twd2/THCOMIPS16e/pre.pptx

## THCO MIPS指令计算机系统设计和实现

Project 4 & 5

## 我们做了什么?

- 指令集实现
- VGA显示
- PS/2键盘
- SD卡访问
  - bootloader
  - 读
  - 写
  - DMA
- 2048游戏
- Bad Apple动画

## datapath

## VGA显示
