twd2/THCOMIPS16e/doc/datapath.png

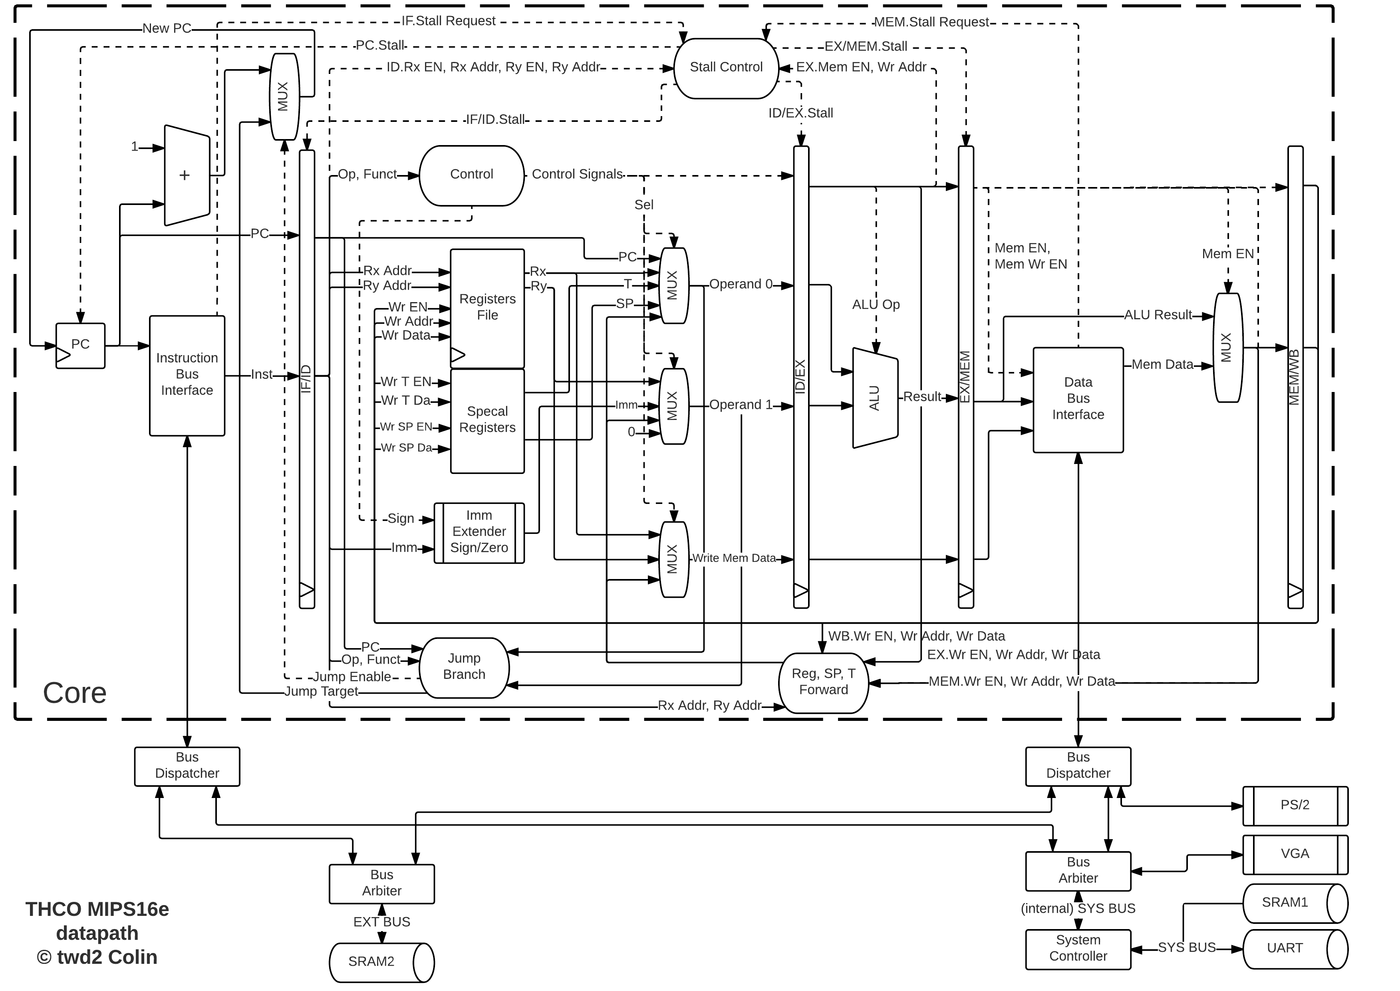
doc/datapath.png
