twd2/THCOMIPS16e/doc/datapath.pdf

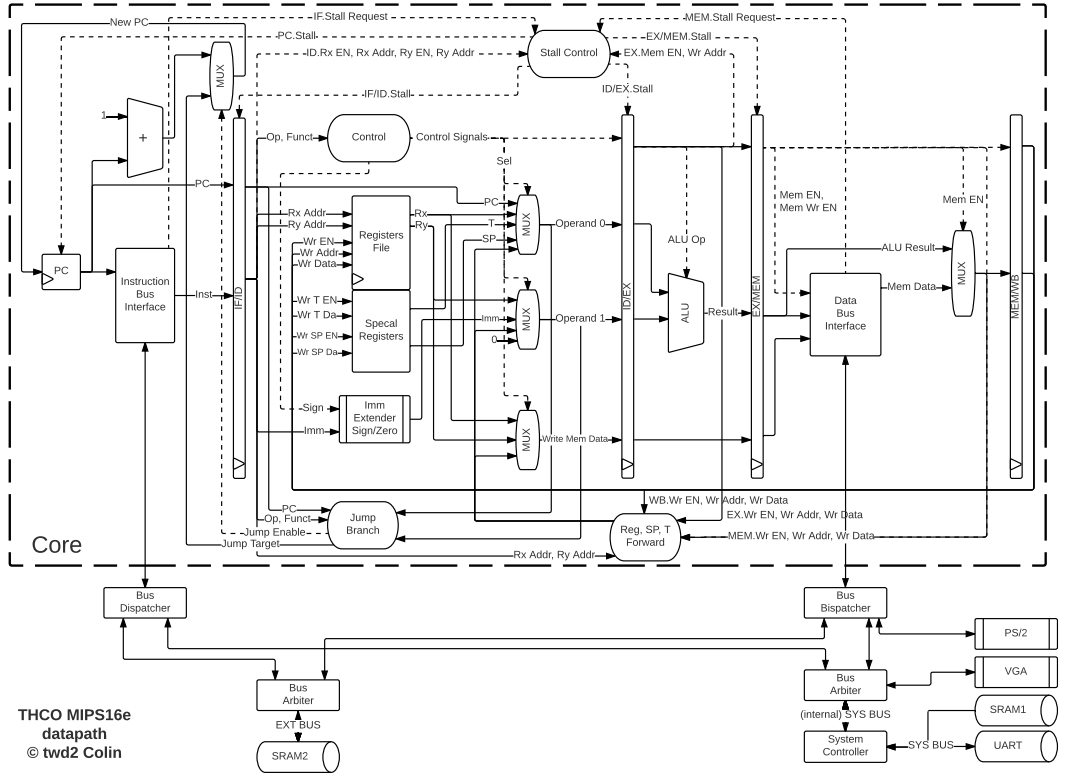
[picture p13: page 1]
Stall Control; MEM/WB; EX/MEM; Instruction Bus; Interface; Data; Bus Interface; Registers File; Bus Dispatcher; Bus Bispatcher; Specal Registers; Bus Arbiter; System Controller SRAM2; SRAM1; UART; Control; Imm Extender Sign/Zero; Jump; Branch; Reg, SP, T; Forward; EXT BUS; SYS BUS; New PC; Inst; Imm; Operand 0; Operand 1; ALU; Mem Data; Result; ALU Result; Jump Enable Jump Target; Control Signals; Wr Addr; Op, Funct; Wr Data; Sel; Sign; IF.Stall Request; MEM.Stall Request; VGA; ALU Op; Core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

PC.Stall
ID.Rx EN, Rx Addr, Ry EN, Ry Addr

EX/MEM.Stall
EX.Mem EN, Wr Addr

IF/ID.Stall

ID/EX.Stall

Mem EN Mem EN, Mem Wr EN

Rx Addr Ry Addr

Write Mem Data

WB.Wr EN, Wr Addr, Wr Data

EX.Wr EN, Wr Addr, Wr Data
MEM.Wr EN, Wr Addr, Wr Data

Rx Addr, Ry Addr

(internal) SYS BUS
