twd2/THCOMIPS16e/sopc/sd_controller.vhd

-- MIT License
-- 
-- Copyright (c) 2017 Wende Tan, Liu Minghua
-- 
-- Permission is hereby granted, free of charge, to any person obtaining a copy
-- of this software and associated documentation files (the "Software"), to deal
-- in the Software without restriction, including without limitation the rights
-- to use, copy, modify, merge, publish, distribute, sublicense, and/or sell
-- copies of the Software, and to permit persons to whom the Software is
-- furnished to do so, subject to the following conditions:
-- 
-- The above copyright notice and this permission notice shall be included in all
-- copies or substantial portions of the Software.
-- 
-- THE SOFTWARE IS PROVIDED "AS IS", WITHOUT WARRANTY OF ANY KIND, EXPRESS OR
-- IMPLIED, INCLUDING BUT NOT LIMITED TO THE WARRANTIES OF MERCHANTABILITY,
-- FITNESS FOR A PARTICULAR PURPOSE AND NONINFRINGEMENT. IN NO EVENT SHALL THE
-- AUTHORS OR COPYRIGHT HOLDERS BE LIABLE FOR ANY CLAIM, DAMAGES OR OTHER
-- LIABILITY, WHETHER IN AN ACTION OF CONTRACT, TORT OR OTHERWISE, ARISING FROM,
-- OUT OF OR IN CONNECTION WITH THE SOFTWARE OR THE USE OR OTHER DEALINGS IN THE
-- SOFTWARE.

library IEEE;
use IEEE.std_logic_1164.all;
use IEEE.std_logic_unsigned.all;
use IEEE.std_logic_arith.all;
use work.constants.all;
use work.types.all;

entity sd_controller is
    generic
    (
        WORD_WIDTH: integer := word_length; -- word width of SRAM
        RAM_SIZE: integer := 32 * 1024 * 16 / 8 -- SRAM size (bytes)
    );
    port
    (
        CLK: in std_logic;
        RST: in std_logic;

        DMA_BUS_REQ: out bus_request_t;
        DMA_BUS_RES: in bus_response_t;
        
        BUS_REQ: in bus_request_t;
        BUS_RES: out bus_response_t;

        SD_nCS: out std_logic; -- SD_NCS, SD_DATA3_CD
        SD_SCLK: out std_logic; -- SD_CLK
        SD_MISO: in std_logic;  -- SD_DOUT, SD_DATA0_DO
        SD_MOSI: out std_logic; -- SD_DIN, SD_CMD

        DONE: out std_logic;
        REJECTED: out std_logic;
        DBG: out std_logic_vector(3 downto 0);
        
        IRQ: out std_logic
    );
end;

architecture behavioral of sd_controller is
    -- timing constants
    constant POWERON_WAIT_CYCLES: integer := 25000; -- 1ms, if CLK = 25M
    constant SPI_WAIT_CYCLES: integer := 1;
    constant DUMMY_CLOCKS: integer := 80;
    constant MAX_RETRY: integer := 16;

    -- data length
    constant CMD_BITS: integer := 48;
    constant BYTE_BITS: integer := 8;
    constant R1_BITS: integer := 8;
    constant DWORD_BUFF_BITS: integer := 32;
    constant SECTOR_SIZE: integer := 512;
    constant WORD_SIZE: integer := WORD_WIDTH / 8;

    -- expected responses
    constant R1_NO_ERROR_IDLE: std_logic_vector(7 downto 0) := x"01";
    constant R1_ILLIGAL_CMD_IDLE: std_logic_vector(7 downto 0) := x"05";
    constant R1_NO_ERROR_NO_IDLE: std_logic_vector(7 downto 0) := x"00";
    constant CMD25_DATA_TOKEN: std_logic_vector(7 downto 0) := x"FC";
    constant CMD25_STOP_TOKEN: std_logic_vector(7 downto 0) := x"FD";

    -- :-)
    type state_t is (st_poweron_wait, st_dummy_clock,
                     st_cmd0_req, st_cmd0_res, st_cmd0_done,
                     st_cmd8_req, st_cmd8_res, st_cmd8_read_r1, st_cmd8_done,
                     st_acmd41_cmd55_req, st_acmd41_cmd55_res, st_acmd41_cmd55_done,
                     st_acmd41_req, st_acmd41_res, st_acmd41_done,
                     st_cmd58_req, st_cmd58_res, st_cmd58_read_r1, st_cmd58_done,
                     st_cmd16_req, st_cmd16_res, st_cmd16_done,
                     st_cmd17_req, st_cmd17_res, st_cmd17_r1,
                     st_cmd17_read_token, st_cmd17_read_data, st_cmd17_read_crc,
                     st_cmd17_write_ram, st_cmd17_write_ram_done, st_cmd17_done,
                     st_cmd25_req, st_cmd25_res, st_cmd25_r1,
                     st_cmd25_send_token, st_cmd25_read_ram, st_cmd25_read_ram_done,
                     st_cmd25_send_data, st_cmd25_send_crc,
                     st_cmd25_read_data_res, st_cmd25_read_data_res2,
                     st_cmd25_next, st_cmd25_send_stop, st_cmd25_done,
                     st_wait_spi, st_send_cmd, st_send_byte, st_wait_busy,
                     st_read_wait, st_read_byte, st_read_4_bytes,
                     st_finish_delay,
                     st_reject, st_done, st_ready);

    signal current_state, wait_return_state, wait_busy_return_state, cmd_return_state, ram_return_state: state_t;

    -- wait_counter ranged 0 to max(SPI_WAIT_CYCLES, POWERON_WAIT_CYCLES) - 1
    signal wait_counter: integer range 0 to POWERON_WAIT_CYCLES - 1;
    signal counter: integer range 0 to 255; -- >= max(DUMMY_CLOCKS, CMD_BITS) * 2 - 1
    signal byte_counter: integer range 0 to SECTOR_SIZE - 1;
    signal retry_counter: integer range 0 to MAX_RETRY - 1; -- TODO: retry
    signal sector_counter: integer range 0 to integer'high;

    signal sd_sclk_buff: std_logic;

    -- (request) command and argument
    signal cmd: integer range 0 to 63;
    signal arg: std_logic_vector(31 downto 0);
    signal crc: std_logic_vector(6 downto 0);
    signal packet: std_logic_vector(47 downto 0);
    signal sector_as_arg: std_logic_vector(31 downto 0);
    signal finish_delay: std_logic; -- delay or not after a command

    -- buffers
    signal byte_buff: std_logic_vector(7 downto 0);
    signal dword_buff: std_logic_vector(31 downto 0);
    signal word_buff: std_logic_vector(WORD_WIDTH - 1 downto 0);

    -- SD card properties
    signal is_sdc2, is_sdhc: std_logic;
    
    signal booted: std_logic;
    
    signal last_state: state_t;
    
    -- registers
    signal irq_buff: std_logic;
    signal sector_base: std_logic_vector(31 downto 0);
    signal ram_base: std_logic_vector(31 downto 0);
    signal sector_count: std_logic_vector(31 downto 0);
begin
    SD_SCLK <= sd_sclk_buff;

    packet <= "01" & conv_std_logic_vector(cmd, 6) & arg & crc & "1";

    sector_as_arg_process:
    process(sector_counter, is_sdhc)
    begin
        -- block addressing when SD card is SDHC/SDXC, otherwise, byte addressing.
        -- ref:
        -- SD Specifications Part 1 Physical Layer Simplified Specification
        --     Table 7-3 : Commands and Arguments (small print)
        --     10. SDSC Card (CCS=0) uses byte unit address and 
        --     SDHC and SDXC Cards (CCS=1) use block unit address (512 bytes unit).
        if is_sdhc = '1' then -- block addressing
            sector_as_arg <= conv_std_logic_vector(conv_integer(unsigned(sector_base)) + sector_counter, sector_as_arg'length);
        else -- byte addressing, 512 bytes aligned
            sector_as_arg <= conv_std_logic_vector((conv_integer(unsigned(sector_base)) + sector_counter) * SECTOR_SIZE,
                                                   sector_as_arg'length);
        end if;
    end process;
    
    DMA_BUS_REQ.is_uart_data <= '0';
    DMA_BUS_REQ.is_uart_control <= '0';
    
    process(CLK, RST)
    begin
        if RST = '1' then
            current_state <= st_poweron_wait;
            wait_counter <= 0;
            counter <= 0;
            sd_sclk_buff <= '0';
            SD_nCS <= '1';
            SD_MOSI <= '1';
            byte_buff <= (others => '0');
            dword_buff <= (others => '0');
            DBG <= (others => '0');
            retry_counter <= 0;
            is_sdc2 <= '0';
            is_sdhc <= '0';
            finish_delay <= '1';
            sector_counter <= 0;
            byte_counter <= 0;
            DMA_BUS_REQ.en <= '1';
            DMA_BUS_REQ.nread_write <= '0';
            DMA_BUS_REQ.byte_mask <= (others => '1');
            DMA_BUS_REQ.addr <= (others => '0');
            booted <= '0';
        elsif rising_edge(CLK) then
            case current_state is
                ------------------------------------------------------------------------------
                -- SD card initialization
                -- ref:
                -- SD Specifications Part 1 Physical Layer Simplified Specification
                --     7.2.1 Mode Selection and Initialization
                --     Figure 7-2 : SPI Mode Initialization Flow
                -- 1. wait 1+ ms
                when st_poweron_wait =>
                    sd_sclk_buff <= '1';
                    if wait_counter = POWERON_WAIT_CYCLES - 1 then
                        current_state <= st_dummy_clock;
                        wait_counter <= 0;
                    else
                        wait_counter <= wait_counter + 1;
                    end if;
                -- 2. 74+ dummy clocks
                when st_dummy_clock =>
                    SD_nCS <= '1';
                    SD_MOSI <= '1';
                    sd_sclk_buff <= not sd_sclk_buff;
                    if counter = DUMMY_CLOCKS * 2 - 1 then
                        wait_return_state <= st_cmd0_req;
                        current_state <= st_wait_spi;
                        counter <= 0;
                    else
                        wait_return_state <= st_dummy_clock;
                        current_state <= st_wait_spi;
                        counter <= counter + 1;
                    end if;
                -- 3. CMD0 GO_IDLE_STATE
                when st_cmd0_req =>
                    SD_nCS <= '0';
                    cmd <= 0;
                    arg <= x"00000000";
                    crc <= "1001010"; -- CRC is needed.
                    cmd_return_state <= st_cmd0_res;
                    current_state <= st_send_cmd;
                    counter <= 0;
                when st_cmd0_res =>
                    finish_delay <= '0';
                    cmd_return_state <= st_cmd0_done;
                    current_state <= st_read_wait;
                when st_cmd0_done =>
                    if byte_buff = R1_NO_ERROR_IDLE then
                        current_state <= st_cmd8_req;
                    else
                        DBG <= x"1";
                        current_state <= st_reject;
                    end if;
                -- 4. CMD8 SEND_IF_COND
                when st_cmd8_req =>
                    SD_nCS <= '0';
                    cmd <= 8;
                    arg <= x"000001AA";
                    crc <= "1000011"; -- CRC is needed.
                    cmd_return_state <= st_cmd8_res;
                    current_state <= st_send_cmd;
                    counter <= 0;
                when st_cmd8_res =>
                    finish_delay <= '0';
                    cmd_return_state <= st_cmd8_read_r1;
                    current_state <= st_read_wait;
                when st_cmd8_read_r1 =>
                    if byte_buff = R1_NO_ERROR_IDLE then
                        -- This card supports CMD8, so it is SDC2+.
                        is_sdc2 <= '1';
                        finish_delay <= '1';
                        cmd_return_state <= st_cmd8_done;
                        current_state <= st_read_4_bytes;
                    elsif byte_buff = R1_ILLIGAL_CMD_IDLE then
                        -- Otherwise, it is SDC1.
                        is_sdc2 <= '0';
                        cmd_return_state <= st_acmd41_cmd55_req;
                        current_state <= st_finish_delay;
                    else
                        -- TODO: retry count
                        DBG <= x"8";
                        current_state <= st_cmd8_req;
                    end if;
                when st_cmd8_done =>
                    if dword_buff(11 downto 0) = x"1AA" then
                        -- magic number matches
                        current_state <= st_acmd41_cmd55_req;
                    else
                        DBG <= x"8";
                        current_state <= st_reject;
                    end if;
                -- 5.1 CMD55 APP_CMD for ACMD41
                when st_acmd41_cmd55_req =>
                    SD_nCS <= '0';
                    cmd <= 55; -- well, it's decimal.
                    arg <= x"00000000";
                    crc <= "0110010"; -- actually, don't care
                    cmd_return_state <= st_acmd41_cmd55_res;
                    current_state <= st_send_cmd;
                    counter <= 0;
                when st_acmd41_cmd55_res =>
                    finish_delay <= '1';
                    cmd_return_state <= st_acmd41_cmd55_done;
                    current_state <= st_read_wait;
                when st_acmd41_cmd55_done =>
                    if byte_buff = R1_NO_ERROR_IDLE then
                        -- SD_nCS <= '1';
                        current_state <= st_acmd41_req;
                    else
                        -- TODO: retry count
                        current_state <= st_acmd41_cmd55_req; -- ???
                        DBG <= x"5";
                        -- current_state <= st_reject;
                    end if;
                -- 5.2 ACMD41 APP_SEND_OP_COND
                when st_acmd41_req =>
                    SD_nCS <= '0';
                    cmd <= 41;
                    if is_sdc2 = '1' then
                        -- HCS = 1, declares this controller supports high capacity cards.
                        arg <= x"40000000";
                        crc <= "0111011"; -- actually, don't care
                    else
                        arg <= x"00000000"; -- HCS = 0
                        crc <= "1110010"; -- actually, don't care
                    end if;
                    cmd_return_state <= st_acmd41_res;
                    current_state <= st_send_cmd;
                    counter <= 0;
                when st_acmd41_res =>
                    finish_delay <= '1';
                    cmd_return_state <= st_acmd41_done;
                    current_state <= st_read_wait;
                when st_acmd41_done =>
                    if byte_buff = R1_NO_ERROR_IDLE then
                        -- loop until the card responses R1_NO_ERROR_NO_IDLE
                        --                                           ~~~~~~~
                        current_state <= st_acmd41_cmd55_req;
                    elsif byte_buff = R1_NO_ERROR_NO_IDLE then
                        -- the card is initialized.
                        current_state <= st_cmd58_req;
                    else
                        -- current_state <= st_cmd55_req; -- ???
                        DBG <= x"4";
                        current_state <= st_reject;
                    end if;
                -- 6. CMD58 READ_OCR
                when st_cmd58_req =>
                    SD_nCS <= '0';
                    cmd <= 58;
                    arg <= x"00000000";
                    crc <= "1111110"; -- actually, don't care
                    cmd_return_state <= st_cmd58_res;
                    current_state <= st_send_cmd;
                    counter <= 0;
                when st_cmd58_res =>
                    finish_delay <= '0';
                    cmd_return_state <= st_cmd58_read_r1;
                    current_state <= st_read_wait;
                when st_cmd58_read_r1 =>
                    if byte_buff = R1_NO_ERROR_NO_IDLE then
                        finish_delay <= '1';
                        cmd_return_state <= st_cmd58_done;
                        current_state <= st_read_4_bytes;
                    else
                        -- TODO: retry count
                        DBG <= x"8";
                        current_state <= st_reject;
                    end if;
                when st_cmd58_done =>
                    -- read CCS bit.
                    -- ref: SD Specifications Part 1 Physical Layer Simplified Specification
                    --     Table 5-1 : OCR Register Definition
                    --     30 Card Capacity Status (CCS)1
                    --     1) This bit is valid only when the card power up status bit is set.
                    is_sdhc <= dword_buff(30); -- CCS, '1' represents high capacity card
                    current_state <= st_cmd16_req;
                -- 7. CMD16 SET_BLOCKLEN
                -- This command ensures block length 512 bytes for SDSC. 
                -- In case of SDHC and SDXC Cards,
                -- block length of the memory access commands are fixed to 512 bytes.
                when st_cmd16_req =>
                    SD_nCS <= '0';
                    cmd <= 16;
                    arg <= x"00000200"; -- 512 bytes per block
                    crc <= "0001010"; -- actually, don't care
                    cmd_return_state <= st_cmd16_res;
                    current_state <= st_send_cmd;
                    counter <= 0;
                when st_cmd16_res =>
                    finish_delay <= '1';
                    cmd_return_state <= st_cmd16_done;
                    current_state <= st_read_wait;
                when st_cmd16_done =>
                    if byte_buff = R1_NO_ERROR_NO_IDLE then
                        -- SD card is initialized.
                        current_state <= st_cmd17_req; -- bootloader
                        -- use st_ready to skip bootloader
                    else
                        DBG <= x"6";
                        current_state <= st_reject;
                    end if;
                ------------------------------------------------------------------------------
                -- Reader: CMD17 READ_SINGLE_BLOCK
                when st_cmd17_req =>
                    SD_nCS <= '0';
                    cmd <= 17;
                    arg <= sector_as_arg;
                    crc <= "1111111"; -- actually, don't care
                    cmd_return_state <= st_cmd17_res;
                    current_state <= st_send_cmd;
                    counter <= 0;
                when st_cmd17_res =>
                    finish_delay <= '0';
                    cmd_return_state <= st_cmd17_r1;
                    current_state <= st_read_wait;
                when st_cmd17_r1 =>
                    DBG <= x"C";
                    if byte_buff = R1_NO_ERROR_NO_IDLE then
                        cmd_return_state <= st_cmd17_read_token;
                        current_state <= st_read_byte;
                    else
                        DBG <= x"7";
                        current_state <= st_reject;
                    end if;
                when st_cmd17_read_token =>
                    DBG <= x"D";
                    if byte_buff = x"FF" then -- not a token, wait
                        cmd_return_state <= st_cmd17_read_token;
                        current_state <= st_read_byte;
                    elsif byte_buff = x"FE" then -- data token
                        cmd_return_state <= st_cmd17_read_data;
                        current_state <= st_read_byte;
                        byte_counter <= 0;
                    elsif byte_buff(7 downto 5) = "000" then -- error token
                        DBG <= x"7";
                        cmd_return_state <= st_reject;
                        current_state <= st_finish_delay;
                    else
                        DBG <= x"7";
                        cmd_return_state <= st_reject;
                    end if;
                when st_cmd17_read_data =>
                    -- next byte
                    DBG <= x"E";
                    word_buff <= byte_buff & word_buff(WORD_WIDTH - 1 downto 8); -- little-endian
                    if byte_counter = SECTOR_SIZE - 1 then
                        -- assert byte_counter mod WORD_SIZE = WORD_SIZE - 1
                        DMA_BUS_REQ.addr <= conv_std_logic_vector(
                            conv_integer(unsigned(ram_base)) +
                            (sector_counter * SECTOR_SIZE + byte_counter) / WORD_SIZE,
                            DMA_BUS_REQ.addr'length
                        );
                        cmd_return_state <= st_cmd17_read_crc;
                        ram_return_state <= st_read_byte;
                        current_state <= st_cmd17_write_ram;
                        byte_counter <= 0;
                    else
                        if byte_counter mod WORD_SIZE = WORD_SIZE - 1 then
                            DMA_BUS_REQ.addr <= conv_std_logic_vector(
                                conv_integer(unsigned(ram_base)) +
                                (sector_counter * SECTOR_SIZE + byte_counter) / WORD_SIZE,
                                DMA_BUS_REQ.addr'length
                            );
                            cmd_return_state <= st_cmd17_read_data;
                            ram_return_state <= st_read_byte;
                            current_state <= st_cmd17_write_ram;
                        else
                            cmd_return_state <= st_cmd17_read_data;
                            current_state <= st_read_byte;
                        end if;
                        byte_counter <= byte_counter + 1;
                    end if;
                when st_cmd17_write_ram =>
                    DMA_BUS_REQ.en <= '1';
                    DMA_BUS_REQ.nread_write <= '1';
                    DMA_BUS_REQ.data <= word_buff;
                    current_state <= st_cmd17_write_ram_done;
                when st_cmd17_write_ram_done =>
                    if DMA_BUS_RES.done = '1' then
                        if booted = '1' then
                            DMA_BUS_REQ.en <= '0';
                        else
                            -- keep BUS_REQ.en = '1' to block Instruction Fetch
                        end if;
                        DMA_BUS_REQ.nread_write <= '0';
                        current_state <= ram_return_state;
                    end if;
                when st_cmd17_read_crc =>
                    -- eats dummy CRC bytes
                    DBG <= x"F";
                    if byte_counter = 2 - 1 then
                        cmd_return_state <= st_cmd17_done;
                        current_state <= st_finish_delay;
                        byte_counter <= 0;
                    else
                        cmd_return_state <= st_cmd17_read_crc;
                        current_state <= st_read_byte;
                        byte_counter <= byte_counter + 1;
                    end if;
                when st_cmd17_done =>
                    -- next sector
                    if sector_counter = sector_count - 1 then
                        current_state <= st_ready;
                        sector_counter <= 0;
                    else
                        sector_counter <= sector_counter + 1;
                        current_state <= st_cmd17_req;
                    end if;
                ------------------------------------------------------------------------------
                -- Writer: CMD25 WRITE_MULTIPLE_BLOCK
                when st_cmd25_req =>
                    SD_nCS <= '0';
                    cmd <= 25;
                    arg <= sector_as_arg;
                    crc <= "1111111"; -- actually, don't care
                    cmd_return_state <= st_cmd25_res;
                    current_state <= st_send_cmd;
                    counter <= 0;
                when st_cmd25_res =>
                    finish_delay <= '0';
                    cmd_return_state <= st_cmd25_r1;
                    current_state <= st_read_wait;
                when st_cmd25_r1 =>
                    DBG <= x"C";
                    if byte_buff = R1_NO_ERROR_NO_IDLE then
                        -- current_state <= st_cmd25_send_token;
                        byte_buff <= x"FF";
                        cmd_return_state <= st_cmd25_send_token;
                        current_state <= st_send_byte;
                    else
                        DBG <= x"7";
                        current_state <= st_reject;
                    end if;
                when st_cmd25_send_token =>
                    byte_buff <= CMD25_DATA_TOKEN;
                    cmd_return_state <= st_cmd25_read_ram;
                    current_state <= st_send_byte;
                    byte_counter <= 0;
                when st_cmd25_read_ram =>
                    DMA_BUS_REQ.addr <= conv_std_logic_vector(
                        conv_integer(unsigned(ram_base)) +
                        (sector_counter * SECTOR_SIZE + byte_counter) / WORD_SIZE,
                        DMA_BUS_REQ.addr'length
                    );
                    DMA_BUS_REQ.en <= '1';
                    DMA_BUS_REQ.nread_write <= '0';
                    current_state <= st_cmd25_read_ram_done;
                when st_cmd25_read_ram_done =>
                    if DMA_BUS_RES.done = '1' then
                        DMA_BUS_REQ.en <= '0';
                        word_buff <= DMA_BUS_RES.data;
                        current_state <= st_cmd25_send_data;
                    end if;
                when st_cmd25_send_data =>
                    byte_buff <= word_buff(7 downto 0);
                    word_buff <= (7 downto 0 => 'X') & word_buff(WORD_WIDTH - 1 downto 8);
                    if byte_counter = SECTOR_SIZE - 1 then
                        cmd_return_state <= st_cmd25_send_crc;
                        current_state <= st_send_byte;
                        byte_counter <= 0;
                    else
                        if byte_counter mod WORD_SIZE = WORD_SIZE - 1 then
                            cmd_return_state <= st_cmd25_read_ram;
                        else
                            cmd_return_state <= st_cmd25_send_data;
                        end if;
                        current_state <= st_send_byte;
                        byte_counter <= byte_counter + 1;
                    end if;
                when st_cmd25_send_crc =>
                    byte_buff <= x"FF"; -- don't care
                    if byte_counter = 2 - 1 then
                        cmd_return_state <= st_cmd25_read_data_res;
                        current_state <= st_send_byte;
                        byte_counter <= 0;
                    else
                        cmd_return_state <= st_cmd25_send_crc;
                        current_state <= st_send_byte;
                        byte_counter <= byte_counter + 1;
                    end if;
                when st_cmd25_read_data_res =>
                    cmd_return_state <= st_cmd25_read_data_res2;
                    current_state <= st_read_byte;
                when st_cmd25_read_data_res2 =>
                    DBG <= x"D";
                    if byte_buff(4 downto 0) = "00101" then
                        wait_busy_return_state <= st_cmd25_next;
                        current_state <= st_wait_busy;
                    else
                        DBG <= x"2";
                        current_state <= st_reject;
                    end if;
                when st_cmd25_next =>
                    -- next sector
                    if sector_counter = sector_count - 1 then
                        -- send stop
                        byte_buff <= CMD25_STOP_TOKEN;
                        cmd_return_state <= st_cmd25_send_stop;
                        current_state <= st_send_byte;
                        sector_counter <= 0;
                    else
                        sector_counter <= sector_counter + 1;
                        current_state <= st_cmd25_send_token;
                    end if;
                when st_cmd25_send_stop =>
                    byte_buff <= x"FF"; -- send a dummy byte
                    wait_busy_return_state <= st_cmd25_done;
                    cmd_return_state <= st_wait_busy;
                    current_state <= st_send_byte;
                when st_cmd25_done =>
                    -- TODO: ACMD22 SEND_NUM_WR_BLOCKS to check number of well written blocks
                    DBG <= x"E";
                    cmd_return_state <= st_ready;
                    current_state <= st_finish_delay;
                ------------------------------------------------------------------------------
                -- Subroutines --
                -- delay for low speed SPI.
                when st_wait_spi =>
                    if wait_counter = SPI_WAIT_CYCLES - 1 then
                        current_state <= wait_return_state;
                        wait_counter <= 0;
                    else
                        wait_counter <= wait_counter + 1;
                    end if;
                -- send a command to SPI bus
                when st_send_cmd =>
                    if counter mod 2 = 0 then
                        SD_MOSI <= packet(CMD_BITS - 1 - counter / 2);
                        sd_sclk_buff <= '0';
                    else
                        sd_sclk_buff <= '1';
                    end if;
                    if counter = (CMD_BITS * 2) - 1 then
                        wait_return_state <= cmd_return_state;
                        current_state <= st_wait_spi;
                        counter <= 0;
                    else
                        wait_return_state <= st_send_cmd;
                        current_state <= st_wait_spi;
                        counter <= counter + 1;
                    end if;
                -- send a byte
                when st_send_byte =>
                    if counter mod 2 = 0 then
                        SD_MOSI <= byte_buff(BYTE_BITS - 1 - counter / 2);
                        sd_sclk_buff <= '0';
                    else
                        sd_sclk_buff <= '1';
                    end if;
                    if counter = (BYTE_BITS * 2) - 1 then
                        wait_return_state <= cmd_return_state;
                        current_state <= st_wait_spi;
                        counter <= 0;
                    else
                        wait_return_state <= st_send_byte;
                        current_state <= st_wait_spi;
                        counter <= counter + 1;
                    end if;
                -- wait until SD_MISO is high
                when st_wait_busy =>
                    if sd_sclk_buff = '0' then
                        if SD_MISO = '1' then
                            current_state <= wait_busy_return_state;
                            counter <= 0;
                        else
                            wait_return_state <= st_wait_busy;
                            current_state <= st_wait_spi;
                        end if;
                        sd_sclk_buff <= '1';
                    else
                        sd_sclk_buff <= '0';
                        wait_return_state <= st_wait_busy;
                        current_state <= st_wait_spi;
                    end if;
                -- wait until SD_MISO is low, and read a byte from SPI bus
                when st_read_wait =>
                    if sd_sclk_buff = '0' then
                        if SD_MISO = '0' then
                            current_state <= st_read_byte;
                            counter <= 0;
                        else
                            wait_return_state <= st_read_wait;
                            current_state <= st_wait_spi;
                            sd_sclk_buff <= '1';
                        end if;
                    else
                        sd_sclk_buff <= '0';
                        wait_return_state <= st_read_wait;
                        current_state <= st_wait_spi;
                    end if;
                -- read a byte from SPI bus
                when st_read_byte =>
                    if sd_sclk_buff = '0' then
                        byte_buff(R1_BITS - 1 - counter) <= SD_MISO;
                        if counter = R1_BITS - 1 then
                            if finish_delay = '1' then
                                wait_return_state <= st_finish_delay;
                            else
                                wait_return_state <= cmd_return_state;
                            end if;
                            current_state <= st_wait_spi;
                            counter <= 0;
                        else
                            wait_return_state <= st_read_byte;
                            current_state <= st_wait_spi;
                            counter <= counter + 1;
                        end if;
                        sd_sclk_buff <= '1';
                    else
                        sd_sclk_buff <= '0';
                        wait_return_state <= st_read_byte;
                        current_state <= st_wait_spi;
                    end if;
                -- read 4 bytes from SPI bus
                when st_read_4_bytes =>
                    if sd_sclk_buff = '0' then
                        dword_buff(DWORD_BUFF_BITS - 1 - counter) <= SD_MISO;
                        if counter = DWORD_BUFF_BITS - 1 then
                            if finish_delay = '1' then
                                wait_return_state <= st_finish_delay;
                            else
                                wait_return_state <= cmd_return_state;
                            end if;
                            current_state <= st_wait_spi;
                            counter <= 0;
                        else
                            wait_return_state <= st_read_4_bytes;
                            current_state <= st_wait_spi;
                            counter <= counter + 1;
                        end if;
                        sd_sclk_buff <= '1';
                    else
                        sd_sclk_buff <= '0';
                        wait_return_state <= st_read_4_bytes;
                        current_state <= st_wait_spi;
                    end if;
                -- delay several clocks after an operation
                when st_finish_delay =>
                    SD_nCS <= '1';
                    if sd_sclk_buff = '0' then
                        if counter = 8 - 1 then
                            wait_return_state <= cmd_return_state;
                            current_state <= st_wait_spi;
                            counter <= 0;
                        else
                            wait_return_state <= st_finish_delay;
                            current_state <= st_wait_spi;
                            counter <= counter + 1;
                        end if;
                        sd_sclk_buff <= '1';
                    else
                        sd_sclk_buff <= '0';
                        wait_return_state <= st_finish_delay;
                        current_state <= st_wait_spi;
                    end if;
                ------------------------------------------------------------------------------
                when st_reject => -- do nothing
                when st_done => -- do nothing
                when st_ready =>
                    DMA_BUS_REQ.en <= '0';
                    booted <= '1';
                    if BUS_REQ.en = '1' and BUS_REQ.nread_write = '1' then
                        if BUS_REQ.addr(2 downto 0) = "111" then
                            case BUS_REQ.data is
                                when x"0001" => -- read
                                    current_state <= st_cmd17_req;
                                when x"0002" =>
                                    current_state <= st_cmd25_req;
                                when others =>
                            end case;
                        end if;
                    end if;
                when others =>
                    current_state <= st_poweron_wait;
                    wait_counter <= 0;
                    counter <= 0;
            end case;
        end if;
    end process;

    done_out:
    process(CLK, RST)
    begin
        if RST = '1' then
            DONE <= '0';
        else
            if rising_edge(CLK) then
                if current_state = st_done then
                    DONE <= '1';
                else
                    DONE <= '0';
                end if;
            end if;
        end if;
    end process;

    rejected_out:
    process(CLK, RST)
    begin
        if RST = '1' then
            REJECTED <= '0';
        else
            if rising_edge(CLK) then
                if current_state = st_reject then
                    REJECTED <= '1';
                else
                    REJECTED <= '0';
                end if;
            end if;
        end if;
    end process;

    -- registers
    
    BUS_RES.grant <= '1';
    BUS_RES.done <= '1';
    BUS_RES.tlb_miss <= '0';
    BUS_RES.page_fault <= '0';
    BUS_RES.error <= '0';

    read_proc:
    process(BUS_REQ, sector_base, ram_base, sector_count, irq_buff)
    begin
        case BUS_REQ.addr(2 downto 0) is
            when "000" =>
                BUS_RES.data <= sector_base(15 downto 0);
            when "001" =>
                BUS_RES.data <= sector_base(31 downto 16);
            when "010" =>
                BUS_RES.data <= ram_base(15 downto 0);
            when "011" =>
                BUS_RES.data <= ram_base(31 downto 16);
            when "100" =>
                BUS_RES.data <= sector_count(15 downto 0);
            when "101" =>
                BUS_RES.data <= sector_count(31 downto 16);
            when "110" =>
                BUS_RES.data <= (15 downto 1 => '0') & irq_buff;
            when "111" =>
                BUS_RES.data <= (others => '0');
            when others =>
                BUS_RES.data <= (others => 'X');
        end case;
    end process;

    write_proc:
    process(CLK, RST)
    begin
        if RST = '1' then
            sector_base <= (others => '0');
            ram_base <= (others => '0');
            sector_count <= conv_std_logic_vector(RAM_SIZE / SECTOR_SIZE, sector_count'length);
            irq_buff <= '0';
            last_state <= st_poweron_wait;
        elsif rising_edge(CLK) then
            if BUS_REQ.en = '1' and BUS_REQ.nread_write = '1' then
                case BUS_REQ.addr(2 downto 0) is
                    when "000" =>
                        sector_base(15 downto 0) <= BUS_REQ.data;
                    when "001" =>
                        sector_base(31 downto 16) <= BUS_REQ.data;
                    when "010" =>
                        ram_base(15 downto 0) <= BUS_REQ.data;
                    when "011" =>
                        ram_base(31 downto 16) <= BUS_REQ.data;
                    when "100" =>
                        sector_count(15 downto 0) <= BUS_REQ.data;
                    when "101" =>
                        sector_count(31 downto 16) <= BUS_REQ.data;
                    when "110" =>
                        if BUS_REQ.data(0) = '1' then
                            irq_buff <= '0'; -- write 1 to clear
                        end if;
                    when others =>
                end case;
            end if;
            
            if current_state = st_ready and last_state /= st_ready then
                irq_buff <= '1';
            end if;
            last_state <= current_state;
        end if;
    end process;

    IRQ <= irq_buff;
end;
