twd2/THCOMIPS16e/as/literal.asm

hello_world:
.word 'h'
.word 'e'
.word 'l'
.word 'l'
.word 'o'
.word 44
.word 32
.word 'w'
.word 'o'
.word 'r'
.word 'l'
.word 'd'
.word 10
.word 0

prompt:
.word 's'
.word 'h'
.word '#'
.word 32
.word 0

boot_message:
.word 'S'
.word 'y'
.word 's'
.word 't'
.word 'e'
.word 'm'
.word 32
.word 'b'
.word 'o'
.word 'o'
.word 't'
.word 'e'
.word 'd'
.word 32
.word 's'
.word 'u'
.word 'c'
.word 'c'
.word 'e'
.word 's'
.word 's'
.word 'f'
.word 'u'
.word 'l'
.word 'l'
.word 'y'
.word '!'
.word 10
.word 10
.word 'T'
.word 'H'
.word 'C'
.word 'O'
.word 32
.word 'M'
.word 'I'
.word 'P'
.word 'S'
.word '1'
.word '6'
.word 'e'
.word 32
.word '['
.word 'v'
.word 'e'
.word 'r'
.word 's'
.word 'i'
.word 'o'
.word 'n'
.word 32
.word '0'
.word '.'
.word '0'
.word '.'
.word '0'
.word ']'
.word 10
.word 32
.word 32
.word 32
.word 32
.word 'b'
.word 'y'
.word 32
.word 't'
.word 'w'
.word 'd'
.word '2'
.word 32
.word 'a'
.word 'n'
.word 'd'
.word 32
.word 'C'
.word 'o'
.word 'l'
.word 'i'
.word 'n'
.word 10
.word 10
.word 0

server:
.word 's'
.word 'e'
.word 'r'
.word 'v'
.word 'e'
.word 'r'
.word 0

unknown_command:
.word 'U'
.word 'n'
.word 'k'
.word 'n'
.word 'o'
.word 'w'
.word 'n'
.word 32
.word 'c'
.word 'o'
.word 'm'
.word 'm'
.word 'a'
.word 'n'
.word 'd'
.word 58
.word 32
.word 0

running_server:
.word 'R'
.word 'u'
.word 'n'
.word 'n'
.word 'i'
.word 'n'
.word 'g'
.word 32
.word 'k'
.word 'e'
.word 'r'
.word 'n'
.word 'e'
.word 'l'
.word '.'
.word 's'
.word 44
.word 32
.word 'p'
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
.word 'Y'
.word 'F'
.word 32
.word 32
.word 32
.word 32
.word 32

.word 32
.word 32
.word 32
.word 32
.word '5'
.word '1'
.word '2'
.word 32
.word 32
.word 32
.word 32
.word 32

.word 32
.word 32
.word 32
.word 32
.word '1'
.word '0'
.word '2'
.word '4'
.word 32
.word 32
.word 32
.word 32

.word 32
.word 32
.word 32
.word 32
.word 'l'
.word 's'
.word 's'
.word 32
.word 32
.word 32
.word 32
.word 32


_2048_welcome:
.word 'W'
.word 'e'
.word 'l'
.word 'c'
.word 'o'
.word 'm'
.word 'e'
.word 32
.word 't'
.word 'o'
.word 32
.word '2'
.word '0'
.word '4'
.word '8'
.word 32
.word 'g'
.word 'a'
.word 'm'
.word 'e'
.word '!'

_2048_help:
.word '['
.word 'N'
.word ']'
.word 58
.word 32
.word 'n'
.word 'e'
.word 'w'
.word 32
.word 'g'
.word 'a'
.word 'm'
.word 'e'
.word 44
.word 32
.word '['
.word 'Q'
.word ']'
.word 58
.word 32
.word 's'
.word 't'
.word 'o'
.word 'r'
.word 'e'
.word 32
.word 'a'
.word 'n'
.word 'd'
.word 32
.word 'q'
.word 'u'
.word 'i'
.word 't'
.word 44
.word 32
.word '['
.word 'W'
.word ']'
.word '\'
.word '['
.word 'S'
.word ']'
.word '\'
.word '['
.word 'A'
.word ']'
.word '\'
.word '['
.word 'D'
.word ']'
.word 58
.word 32
.word 'u'
.word 'p'
.word '\'
.word 'd'
.word 'o'
.word 'w'
.word 'n'
.word '\'
.word 'l'
.word 'e'
.word 'f'
.word 't'
.word '\'
.word 'r'
.word 'i'
.word 'g'
.word 'h'
.word 't'

_2048_color_const:
.word 0
.word 0xf700
.word 0xe700
.word 0xd700
.word 0xc700
.word 0xb700
.word 0xa700
.word 0x9700
.word 0x5700
.word 0x3700
.word 0x2700
.word 0x1700


__end_of_code__:
