twd2/THCOMIPS16e/sopc/clock_manager.vhd

--------------------------------------------------------------------------------
-- Copyright (c) 1995-2013 Xilinx, Inc.  All rights reserved.
--------------------------------------------------------------------------------
--   ____  ____ 
--  /   /\/   / 
-- /___/  \  /    Vendor: Xilinx 
-- \   \   \/     Version : 14.7
--  \   \         Application : xaw2vhdl
--  /   /         Filename : clock_manager.vhd
-- /___/   /\     Timestamp : 12/08/2017 18:35:42
-- \   \  /  \ 
--  \___\/\___\ 
--
--Command: xaw2vhdl-intstyle C:/Users/twd2/Desktop/thco/THCOMIPS16e/sopc/ipcore_dir/clock_manager.xaw -st clock_manager.vhd
--Design Name: clock_manager
--Device: xc3s1200e-4fg320
--
-- Module clock_manager
-- Generated by Xilinx Architecture Wizard
-- Written for synthesis tool: XST
-- Period Jitter (unit interval) for block DCM_SP_INST = 0.06 UI
-- Period Jitter (Peak-to-Peak) for block DCM_SP_INST = 1.64 ns

library ieee;
use ieee.std_logic_1164.ALL;
use ieee.numeric_std.ALL;
library UNISIM;
use UNISIM.Vcomponents.ALL;

entity clock_manager is
   port ( CLKIN_IN        : in    std_logic; 
          RST_IN          : in    std_logic; 
          CLKFX_OUT       : out   std_logic; 
          CLKFX180_OUT    : out   std_logic; 
          CLKIN_IBUFG_OUT : out   std_logic; 
          CLK0_OUT        : out   std_logic; 
          LOCKED_OUT      : out   std_logic);
end clock_manager;

architecture BEHAVIORAL of clock_manager is
   signal CLKFB_IN        : std_logic;
   signal CLKFX_BUF       : std_logic;
   signal CLKFX180_BUF    : std_logic;
   signal CLKIN_IBUFG     : std_logic;
   signal CLK0_BUF        : std_logic;
   signal GND_BIT         : std_logic;
begin
   GND_BIT <= '0';
   CLKIN_IBUFG_OUT <= CLKIN_IBUFG;
   CLK0_OUT <= CLKFB_IN;
   CLKFX_BUFG_INST : BUFG
      port map (I=>CLKFX_BUF,
                O=>CLKFX_OUT);
   
   CLKFX180_BUFG_INST : BUFG
      port map (I=>CLKFX180_BUF,
                O=>CLKFX180_OUT);
   
   CLKIN_IBUFG_INST : IBUFG
      port map (I=>CLKIN_IN,
                O=>CLKIN_IBUFG);
   
   CLK0_BUFG_INST : BUFG
      port map (I=>CLK0_BUF,
                O=>CLKFB_IN);
   
   DCM_SP_INST : DCM_SP
   generic map( CLK_FEEDBACK => "1X",
            CLKDV_DIVIDE => 2.0,
            CLKFX_DIVIDE => 25,
            CLKFX_MULTIPLY => 18,
            CLKIN_DIVIDE_BY_2 => FALSE,
            CLKIN_PERIOD => 20.000,
            CLKOUT_PHASE_SHIFT => "NONE",
            DESKEW_ADJUST => "SYSTEM_SYNCHRONOUS",
            DFS_FREQUENCY_MODE => "LOW",
            DLL_FREQUENCY_MODE => "LOW",
            DUTY_CYCLE_CORRECTION => TRUE,
            FACTORY_JF => x"C080",
            PHASE_SHIFT => 0,
            STARTUP_WAIT => FALSE)
      port map (CLKFB=>CLKFB_IN,
                CLKIN=>CLKIN_IBUFG,
                DSSEN=>GND_BIT,
                PSCLK=>GND_BIT,
                PSEN=>GND_BIT,
                PSINCDEC=>GND_BIT,
                RST=>RST_IN,
                CLKDV=>open,
                CLKFX=>CLKFX_BUF,
                CLKFX180=>CLKFX180_BUF,
                CLK0=>CLK0_BUF,
                CLK2X=>open,
                CLK2X180=>open,
                CLK90=>open,
                CLK180=>open,
                CLK270=>open,
                LOCKED=>LOCKED_OUT,
                PSDONE=>open,
                STATUS=>open);
   
end BEHAVIORAL;
