twd2/THCOMIPS16e/as/test_timer.asm

b main
nop

.org 0x10
; internal interrupt handler
mfc0 r1, epc
addiu r1, 1 ; skip syscall
mtc0 r1, epc
eret

.org 0x20
; external interrupt handler
mfpc r7
syscall ; nop
mfc0 r0, cause
mfc0 r1, epc
eret

main:
    li r0, 0x77
    li r0, 0x0001
    mtc0 r0, status ; enable exception
    li r0, 0x66
    li r0, 0x22
    li r0, 0x33
$:
    li r2, 0
    lw r2, r0, 0
    bnez r0, $
    li r0, 0x31
