twd2/THCOMIPS16e/(commit log)

2017-10-17 bind pin
2017-10-26 refine 面积优化 section
2017-10-30 fix bugs in sram_controller
    [sram_controller.vhd]
2017-11-08 change to:write sram1->read sram1->write sram2->read sram2->write uart & add data to LEDOutput
2017-11-13 add 问题 sections and generate PDF
2017-11-17 add control.csv
    [control.csv]
2017-11-17 add assembler
2017-11-18 bugfix of uart
2017-11-19 as: la, .word
2017-11-21 modify vga_controller
    [control.csv]
2017-11-21 test im, test uart
2017-11-22 bugfix: may write another address after writing sram Close #1
    [clock_4x.vhd, device_bus_dispatcher.vhd, extbus_interface.vhd, mips_sopc.vhd, sysbus_controller.vhd]
2017-11-22 add instruction decode table & modify default alu_op to X
    [control.csv, control.xls]
2017-11-24 fix store after load, install ps2
    [execute.vhd, instruction_decode.vhd, memory_access.vhd, mips_core.vhd, mips_sopc.vhd, ps2_controller.vhd]
2017-11-25 test and fix ps2
    [as.py, clock_4x.vhd, clock_manager.vhd, device_bus_dispatcher.vhd, test_ps2.asm]
2017-11-30 add keyboard2ascii
    [keyboard2ascii.csv, keyboard2ascii.xlsx]
2017-11-30 add mtc0, mfc0
    [control.xls]
2017-11-30 fix enter
    [keyboard2ascii.csv, keyboard2ascii.xlsx]
2017-12-01 fix long distance branch
    [2048.asm]
2017-12-02 fix print hex
2017-12-05 improve timing for reading UART
2017-12-06 power-on self-test
2017-12-06 add help text, show error code using GPIO
    [literal.asm, selftest.asm]
2017-12-07 fix badapple, add performance test @ 36M
    [badapple.asm]
2017-12-07 interrupt (partially)
2017-12-07 install interrupt (not tested!!!)
2017-12-07 test timer interrupt
2017-12-07 bugfix, timer interrupt
2017-12-07 timer as device
